jimharrigan/MiniVoltMon/Board Image.jpg

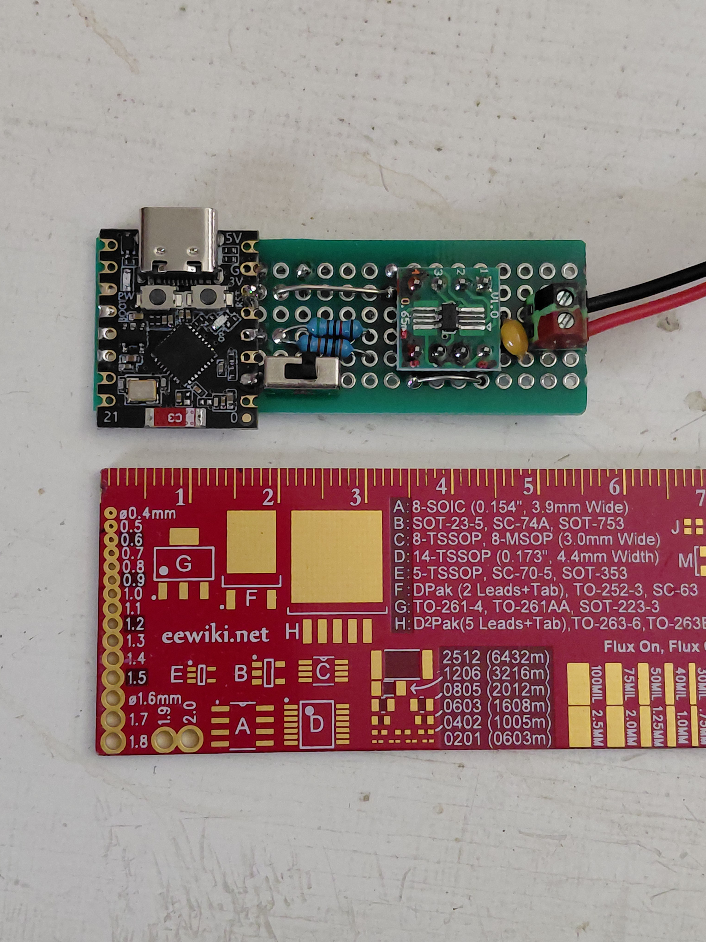
Board Image.jpg
