jimharrigan/MiniVoltMon/case.stl

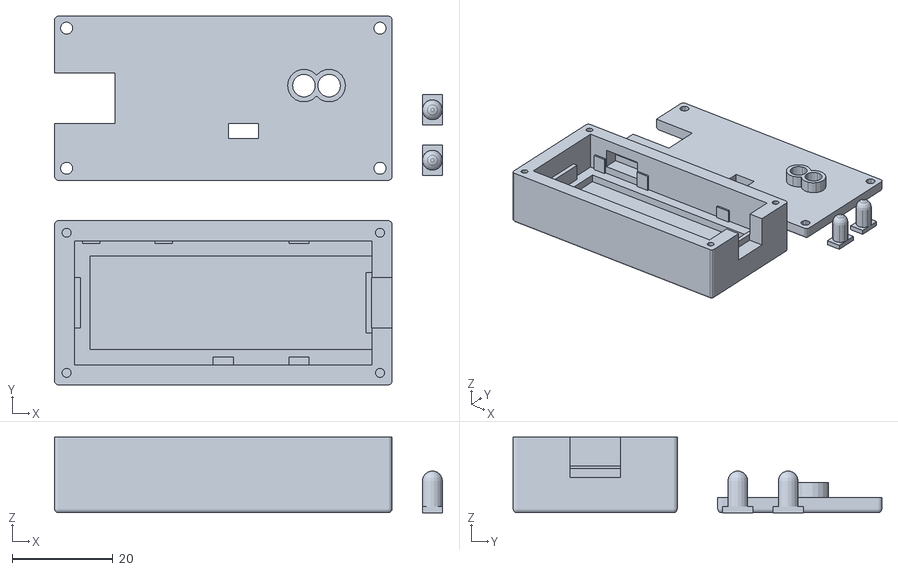
[picture p2: CAD file, 2026-06-14]
case.stl
77.0 x 73.2 x 15.0
