jimharrigan/MiniVoltMon/(commit log)

2026-06-01 Initial commit: MiniVoltMon ESP32-C3 SuperMini voltage monitor
    Single-channel voltage monitor for the ESP32-C3 SuperMini. Reads one
    analog pin via the chip's internal ADC and reports the rolling average
    over WiFi to the same endpoint as the sibling esp-voltage-monitor
    project (key=miniVoltMon).
    Reuses esp-voltage-monitor's WiFi provisioning (netclock/WiFiManager)
    and HTTP reporting design, with the same averaging window
    (VOLTAGE_AVG_SAMPLES) and significant-change threshold (SIG_CHANGE_V).
    The ADS1115 multi-channel path is replaced by a single internal-ADC
    channel. Reporting URL is seeded into NVS on first boot and overridable
    via the config portal.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
    [adc.cpp, config.h, main.cpp, netclock.cpp, netclock.h, reporter.cpp]
2026-06-02 Deep-sleep duty cycle: report once per wake, sleep 10 min
    Each wake connects WiFi, takes one averaged reading, reports it, then
    deep-sleeps for DEEP_SLEEP_MINUTES and repeats indefinitely. The chip
    resets on wake, so setup() runs the full cycle each time.
    - reporter: add pending() so main can sleep only after a send lands (200)
    - main: take a single reading in setup(); loop() drives the send to
    completion then deep-sleeps, with a MAX_AWAKE_MS safety cap so a stuck
    WiFi/send can't sit awake draining the battery (retried next wake)
    - config: add DEEP_SLEEP_MINUTES and MAX_AWAKE_MS
    [config.h, main.cpp, reporter.cpp, reporter.h]
2026-06-07 Make device name (reporting key) configurable via WiFi portal
    The metric key was hardcoded as "miniVoltMon" in reporter.cpp. Expose it as
    an NVS-persisted, portal-configurable Device name, mirroring how the Reporting
    URL is handled. Defaults to "miniVoltMon" (DEFAULT_DEVICE_NAME) on first boot,
    so existing devices keep reporting under the same key until renamed. Empty
    input is ignored so the key can never become blank.
2026-06-07 Move config-portal trigger to GPIO0 and keep portal open while held
    Switch PIN_CONFIG_BUTTON from GPIO9 to GPIO0 (button to GND, active-low).
    GPIO0 is not an ESP32-C3 strapping pin, so it can be held across a hardware
    reset without dropping into ROM download mode — unlike the BOOT button.
    The forced-portal path now loops while the pin reads low instead of until
    WiFi connects, so the portal stays up for as long as GPIO0 is held. On
    release it persists the URL + device name and, if not yet associated, gives
    the stored creds up to 10s to connect before falling through to the no-WiFi
    path.
    [config.h, netclock.cpp]
2026-06-09 Move portal trigger to GPIO1, add startup settle delay, calibrate ADC
    - Config-portal trigger pin moved from GPIO0 to GPIO1 (code + CLAUDE.md docs).
    - Add STARTUP_DELAY_MS (5 s) settle delay on every boot/wake, taken after the
    config button is read so it need not be held through the wait.
    - Two-point ADC calibration: ratio 6.9436, offset -0.2942
    (pin 1.971 V -> 13.98 V, pin 0.677 V -> 4.995 V).
2026-06-11 Tune timing and ADC calibration
    - Reduce startup settle delay from 5 s to 2 s
    - Recalibrate ADC scaling against 4.995 V / 12.48 V references
    - Increase deep-sleep duty cycle from 10 min to 60 min
2026-06-12 manually adjust voltage scaling
